Brillnova/BN-USV-V2/docs/usv-v2-field-test.jpg

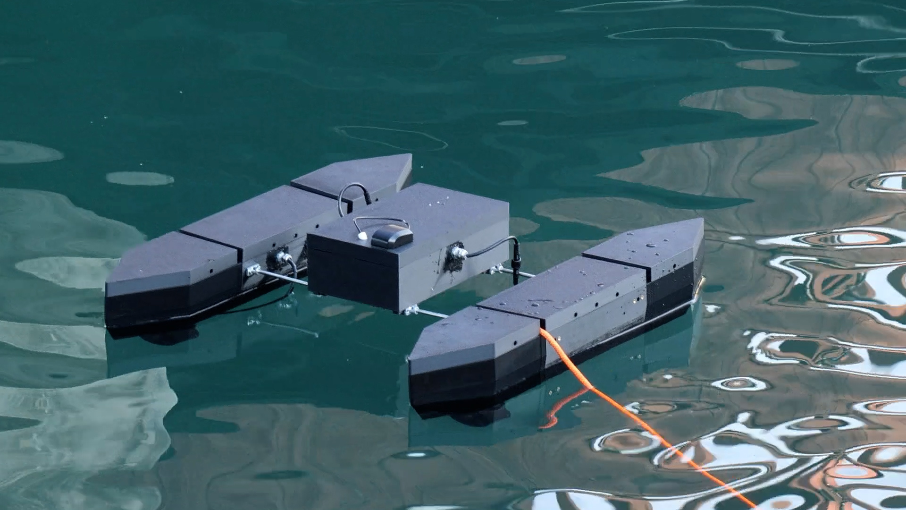
docs/usv-v2-field-test.jpg
