Brillnova/BN-USV-V2/docs/usv-v1.jpg

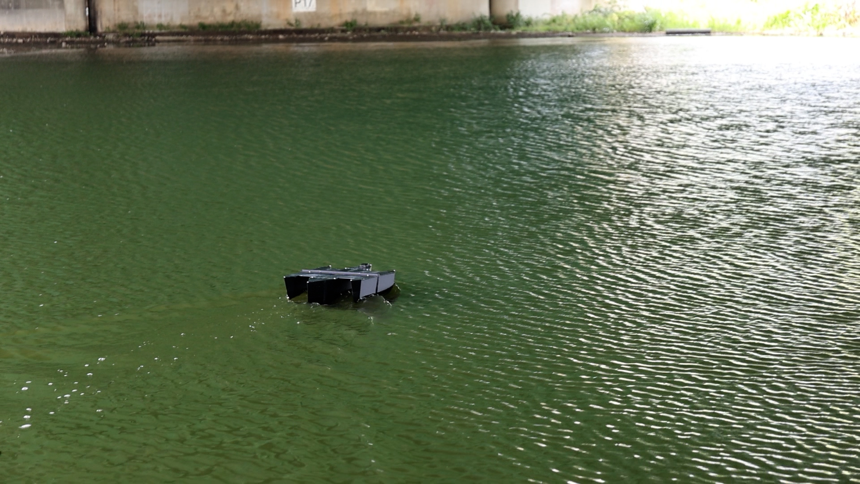
docs/usv-v1.jpg
