Brillnova/BN-USV-V2/hardware/stl/Main Module/Main Module Housing.stl

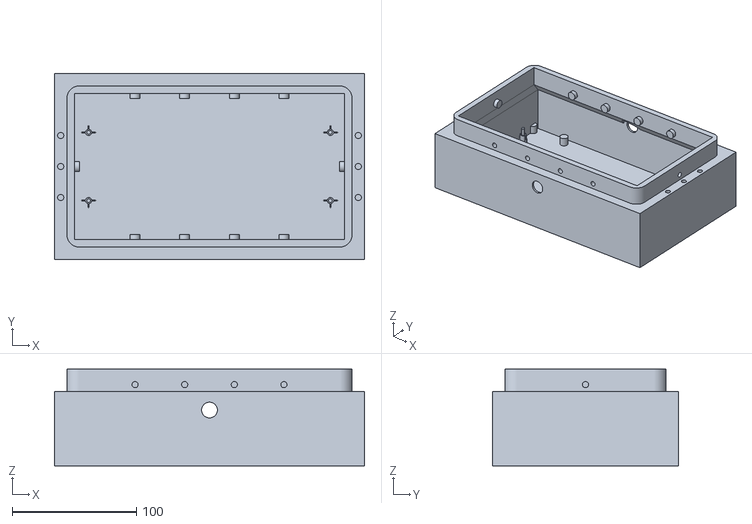
[picture p3: CAD file, 2026-10-26]
hardware/stl/Main Module/Main Module Housing.stl
250.0 x 150.0 x 78.0
