Brillnova/BN-USV-V2/hardware/stl/Weight pallet/Main Module/Weight pallet-Main pcb plate.stl

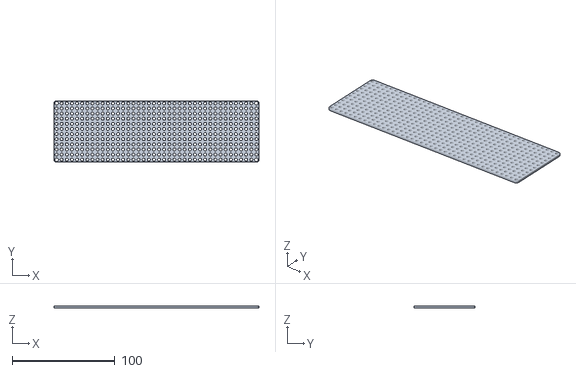
[picture p4: CAD file, 2026-10-26]
hardware/stl/Weight pallet/Main Module/Weight pallet-Main pcb plate.stl
200.0 x 60.0 x 2.00
