Brillnova/BN-USV-V2/hardware/stl/Main Module/Main Module Cover.stl

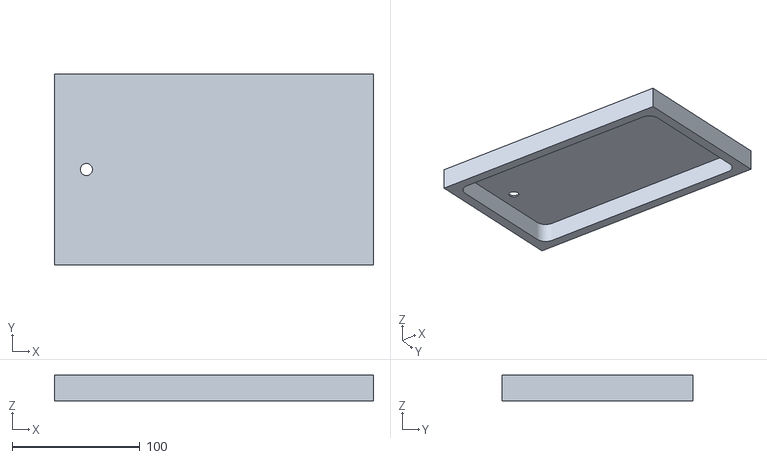
[picture p5: CAD file, 2026-10-26]
hardware/stl/Main Module/Main Module Cover.stl
250.0 x 150.0 x 20.0
