Brillnova/BN-USV-V2/hardware/stl/Main Module/Main Module Axis Support.stl

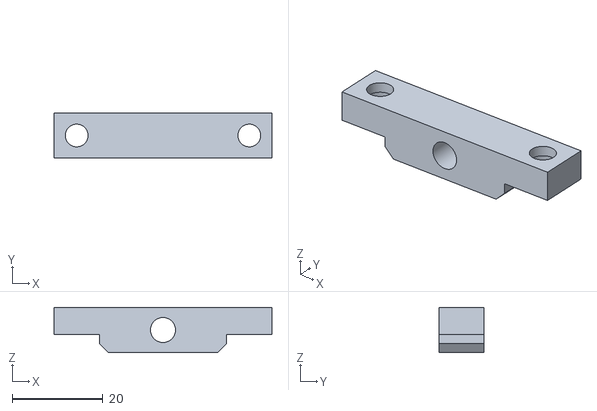
[picture p6: CAD file, 2026-10-26]
hardware/stl/Main Module/Main Module Axis Support.stl
48.0 x 10.0 x 10.0
