Brillnova/BN-USV-V2/hardware/stl/Connection/Module Connection_F.stl

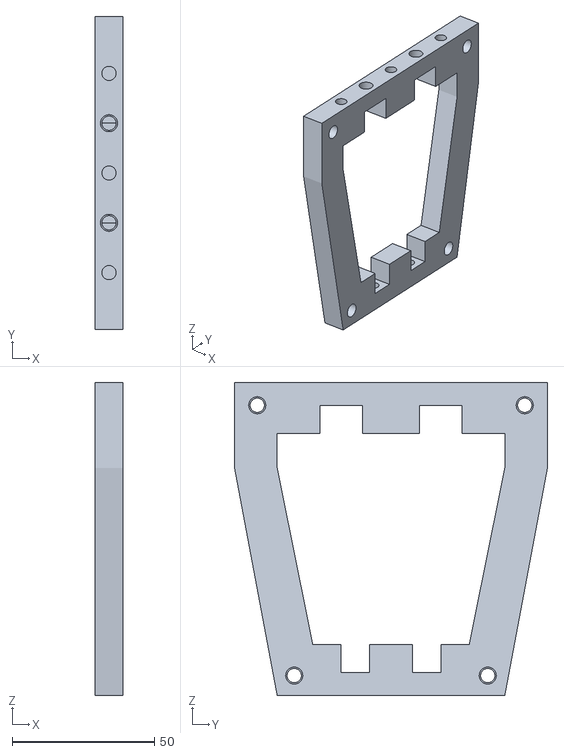
[picture p7: CAD file, 2026-10-26]
hardware/stl/Connection/Module Connection_F.stl
10.0 x 110.0 x 110.0
