Brillnova/BN-USV-V2/hardware/stl/Sub FWD & AFT/Sub FWD Module Housing.stl

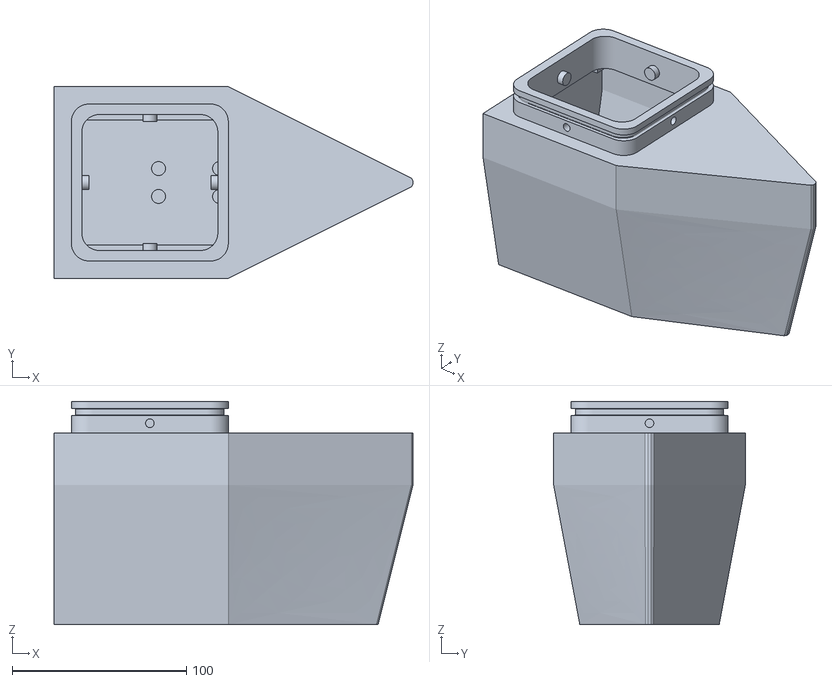
[picture p8: CAD file, 2026-10-26]
hardware/stl/Sub FWD & AFT/Sub FWD Module Housing.stl
206.0 x 110.0 x 128.0
