Brillnova/BN-USV-V2/hardware/stl/Sub Mid/Sub MID Module Housing.stl

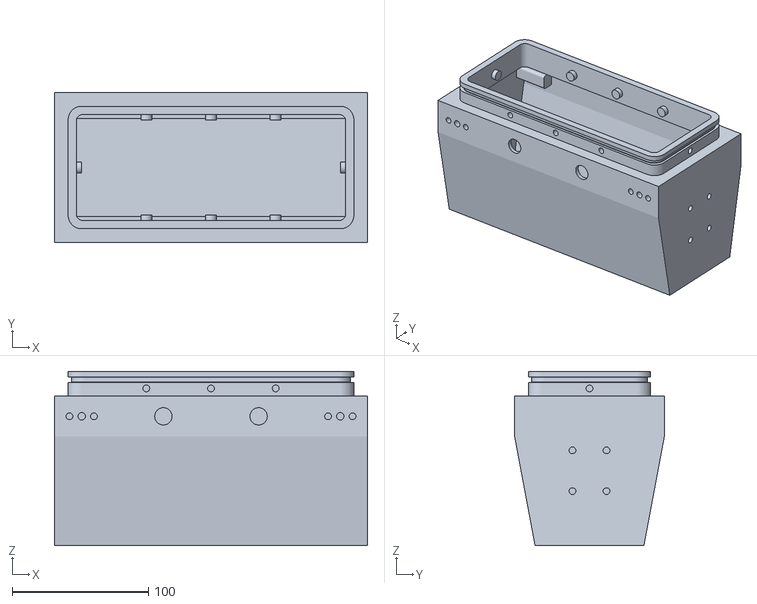
[picture p9: CAD file, 2026-10-26]
hardware/stl/Sub Mid/Sub MID Module Housing.stl
230.0 x 110.0 x 128.0
