Brillnova/BN-USV-V2/hardware/stl/Weight pallet/Tools/Weight pallet-pcb pannel cap.stl

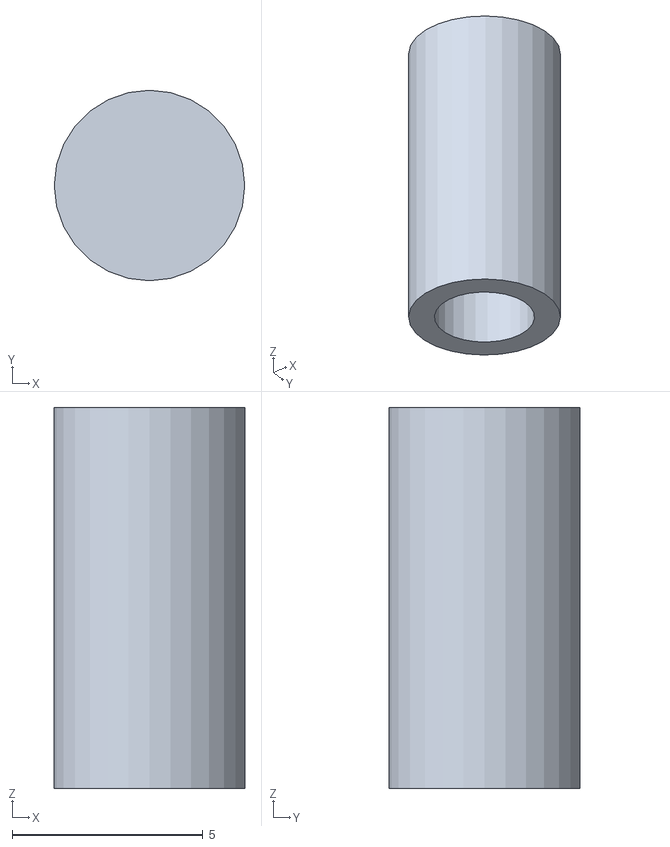
[picture p11: CAD file, 2026-10-26]
hardware/stl/Weight pallet/Tools/Weight pallet-pcb pannel cap.stl
5.00 x 5.00 x 10.0
