Brillnova/BN-USV-V2/hardware/stl/Connection/Module Connection_M.stl

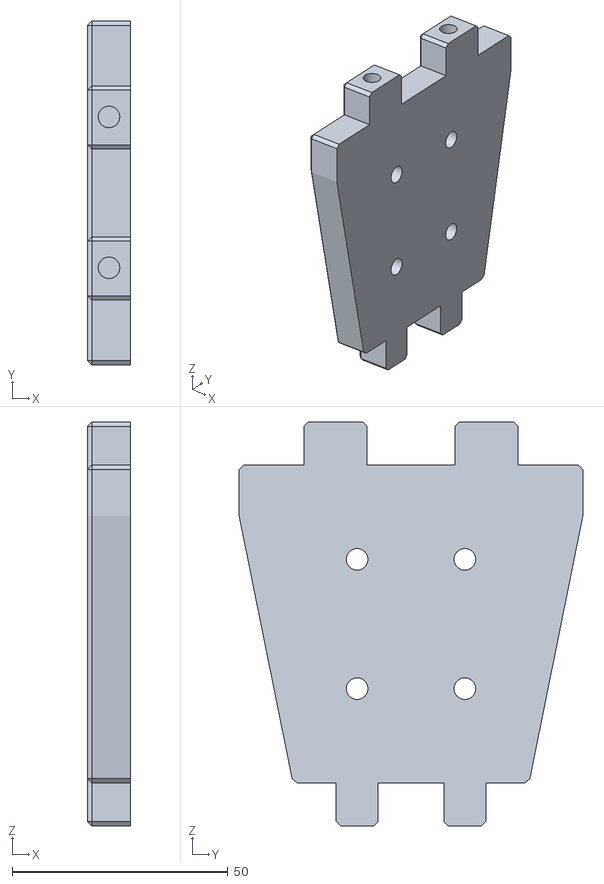
[picture p12: CAD file, 2026-10-26]
hardware/stl/Connection/Module Connection_M.stl
10.0 x 79.7 x 93.7
