Brillnova/BN-USV-V2/hardware/stl/Sub FWD & AFT/Thrust Module_F.stl

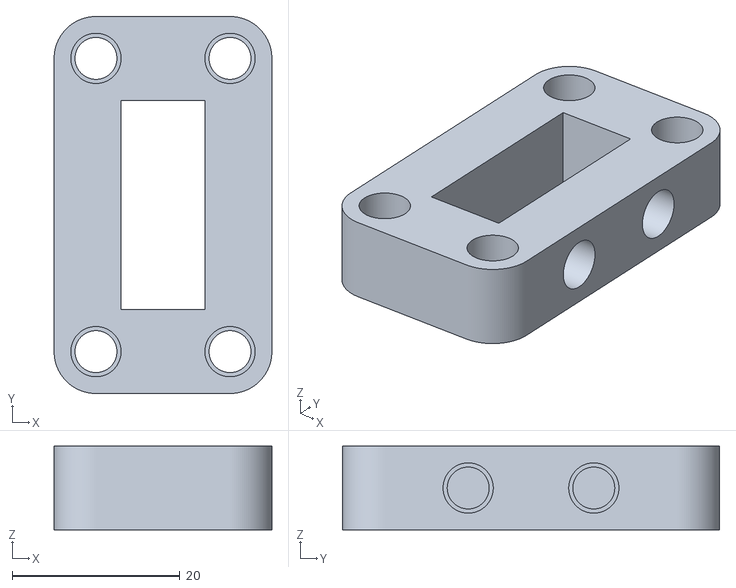
[picture p13: CAD file, 2026-10-26]
hardware/stl/Sub FWD & AFT/Thrust Module_F.stl
26.0 x 45.0 x 10.0
