Brillnova/BN-USV-V2/hardware/stl/Sub Mid/Sub MID Module Housing Cover.stl

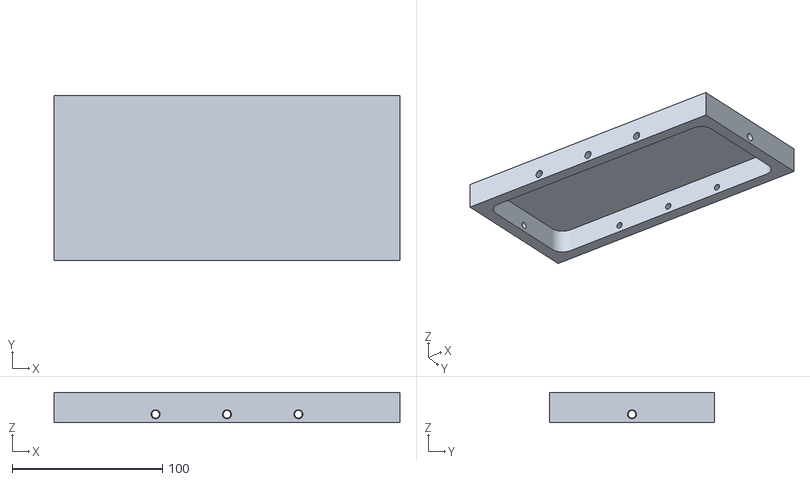
[picture p14: CAD file, 2026-10-26]
hardware/stl/Sub Mid/Sub MID Module Housing Cover.stl
230.0 x 110.0 x 20.0
