Brillnova/BN-USV-V2/hardware/stl/Weight pallet/Sub Module/Weight pallet-AFT_FWD_1st_layer_2.stl

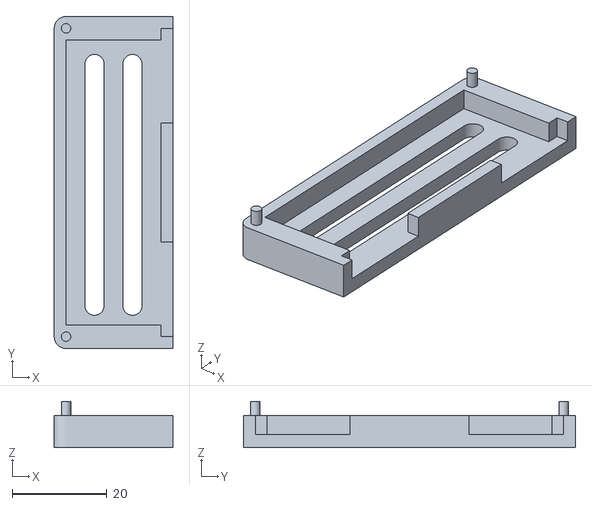
[picture p15: CAD file, 2026-10-26]
hardware/stl/Weight pallet/Sub Module/Weight pallet-AFT_FWD_1st_layer_2.stl
25.0 x 70.0 x 9.80
