Brillnova/BN-USV-V2/hardware/stl/Weight pallet/Tools/Weight pallet-pcb pannel extension.stl

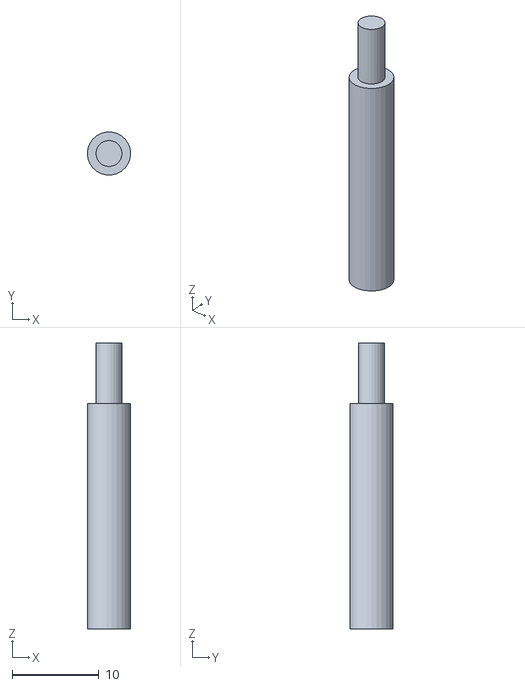
[picture p16: CAD file, 2026-10-26]
hardware/stl/Weight pallet/Tools/Weight pallet-pcb pannel extension.stl
5.00 x 4.96 x 33.0
