Brillnova/BN-USV-V2/hardware/stl/Sub FWD & AFT/Sub FWD Module Cover.stl

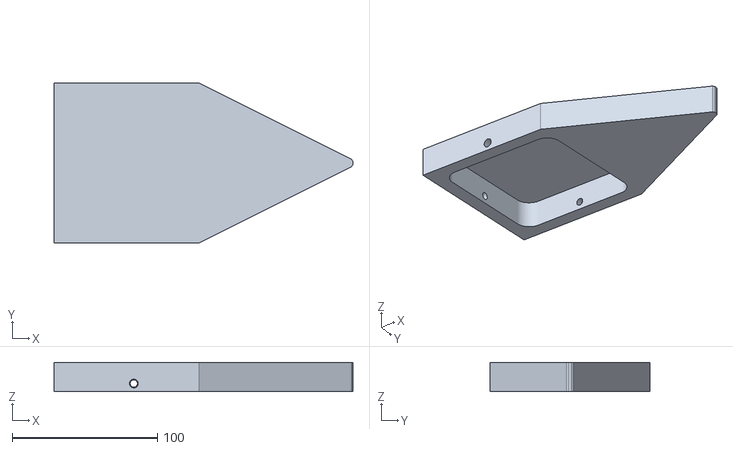
[picture p17: CAD file, 2026-10-26]
hardware/stl/Sub FWD & AFT/Sub FWD Module Cover.stl
206.0 x 110.0 x 20.0
