Brillnova/BN-USV-V2/hardware/stl/Weight pallet/Sub Module/Weight pallet-MID cover plate_1.stl

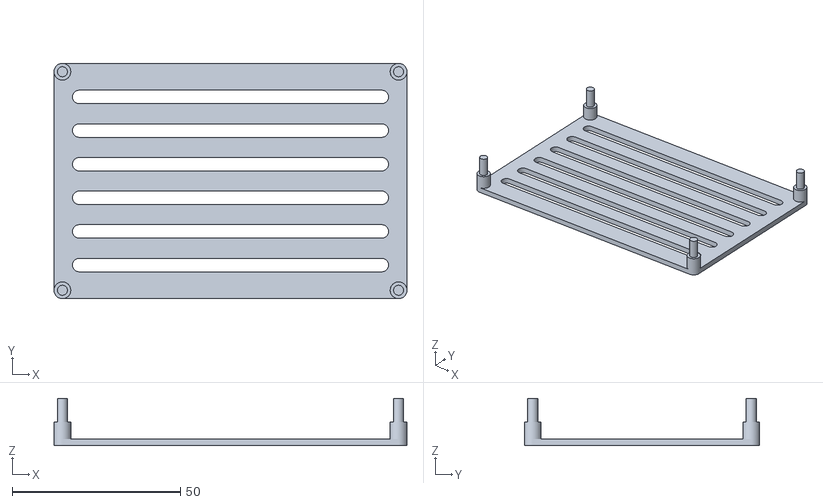
[picture p18: CAD file, 2026-10-26]
hardware/stl/Weight pallet/Sub Module/Weight pallet-MID cover plate_1.stl
105.0 x 70.0 x 14.0
