Brillnova/BN-USV-V2/hardware/stl/Sub FWD & AFT/Thrust Module_M.stl

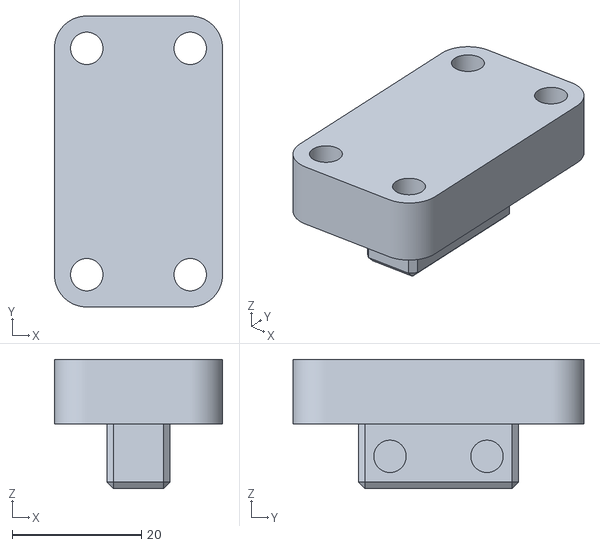
[picture p19: CAD file, 2026-10-26]
hardware/stl/Sub FWD & AFT/Thrust Module_M.stl
26.0 x 45.0 x 20.0
