Brillnova/BN-USV-V2/hardware/stl/Weight pallet/Sub Module/Weight pallet-AFT_FWD_2nd_layer_2.stl

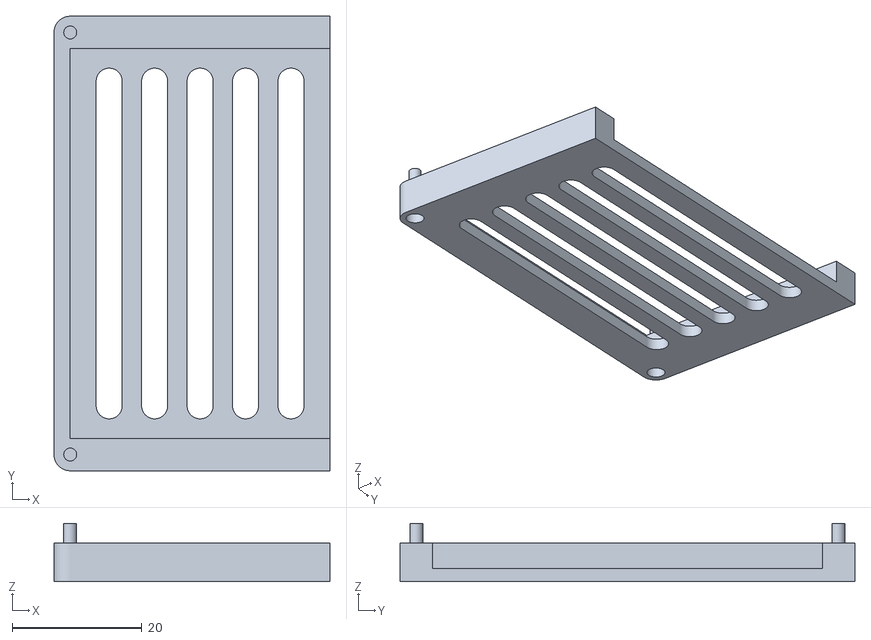
[picture p20: CAD file, 2026-10-26]
hardware/stl/Weight pallet/Sub Module/Weight pallet-AFT_FWD_2nd_layer_2.stl
42.5 x 70.0 x 9.00
