Brillnova/BN-USV-V2/hardware/stl/Weight pallet/Sub Module/Weight pallet-MID pcb plate_2.stl

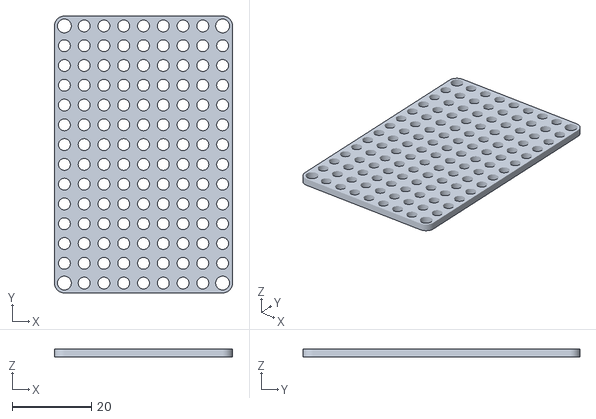
[picture p21: CAD file, 2026-10-26]
hardware/stl/Weight pallet/Sub Module/Weight pallet-MID pcb plate_2.stl
45.0 x 70.0 x 2.00
