Brillnova/BN-USV-V2/hardware/stl/Weight pallet/Sub Module/Weight pallet-MID_1st_layer_1.stl

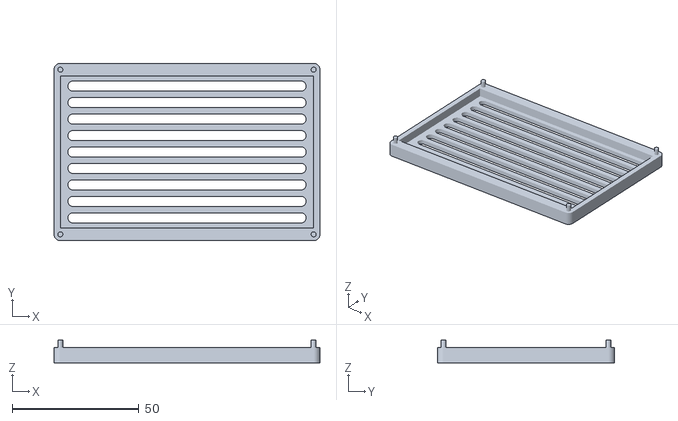
[picture p22: CAD file, 2026-10-26]
hardware/stl/Weight pallet/Sub Module/Weight pallet-MID_1st_layer_1.stl
105.0 x 70.0 x 9.00
