Brillnova/BN-USV-V2/hardware/stl/Weight pallet/Sub Module/Weight pallet-AFT_FWD pcb plate.stl

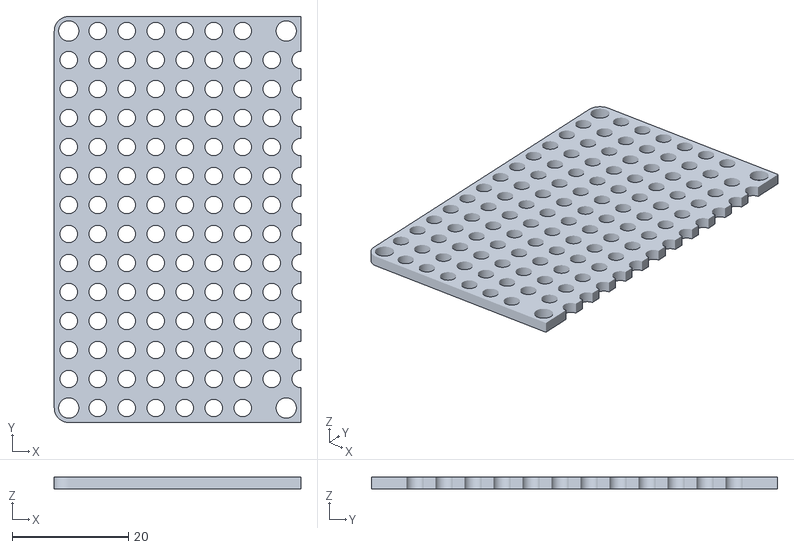
[picture p24: CAD file, 2026-10-26]
hardware/stl/Weight pallet/Sub Module/Weight pallet-AFT_FWD pcb plate.stl
42.5 x 70.0 x 2.00
