Brillnova/BN-USV-V2/hardware/stl/Weight pallet/Sub Module/Weight pallet-AFT_FWD cover plate_1.stl

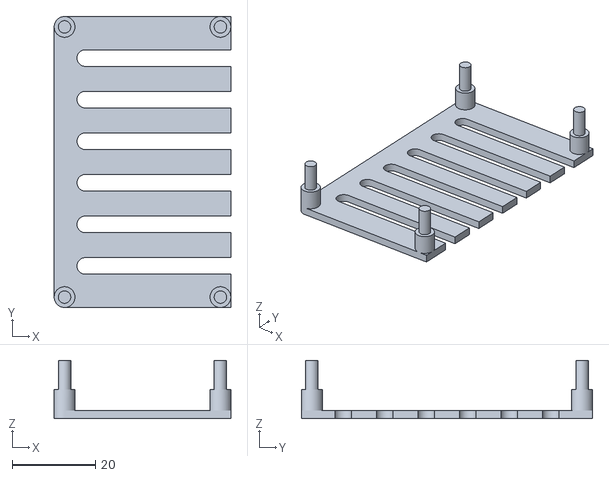
[picture p25: CAD file, 2026-10-26]
hardware/stl/Weight pallet/Sub Module/Weight pallet-AFT_FWD cover plate_1.stl
42.5 x 70.0 x 14.0
