Brillnova/BN-USV-V2/hardware/stl/Weight pallet/Sub Module/Weight pallet-AFT_FWD_tri_1st_layer.stl

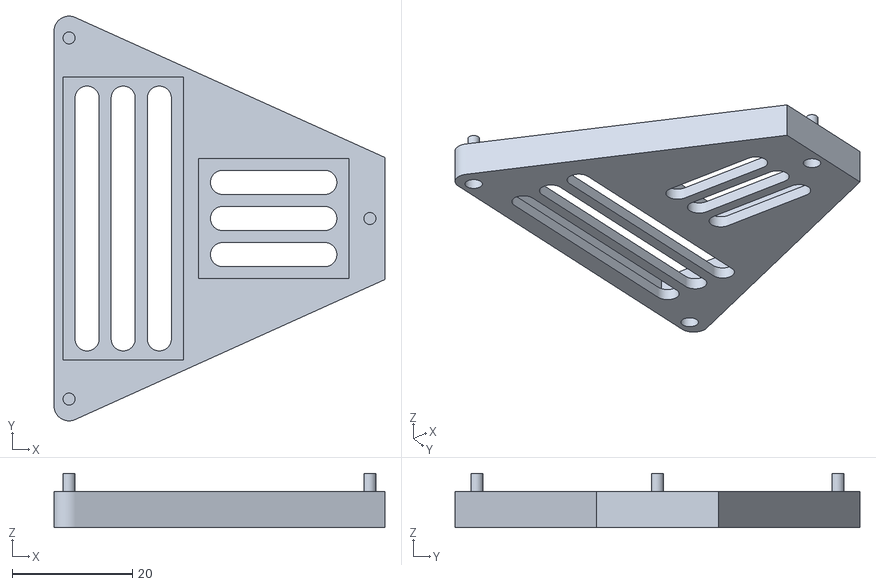
[picture p26: CAD file, 2026-10-26]
hardware/stl/Weight pallet/Sub Module/Weight pallet-AFT_FWD_tri_1st_layer.stl
55.0 x 67.3 x 9.00
