Brillnova/BN-USV-V2/(list of files, cad)

Other CAD files:
hardware/stl/Weight pallet/Sub Module/Weight pallet-MID_1st_layer_2.stl
hardware/stl/Weight pallet/Sub Module/Weight pallet-AFT_FWD_2nd_layer_1.stl
hardware/stl/Weight pallet/Sub Module/Weight pallet-MID cover plate_2.stl
