Brillnova/BN-USV-V2/software/firmware/common/secrets_example.h

#pragma once

// Copy this file to firmware/common/secrets.h for local bench builds.
// Do not commit real Wi-Fi credentials.

#define ENABLE_OTA 1
#define BN_WIFI_SSID "your-wifi-ssid"
#define BN_WIFI_PASSWORD "your-wifi-password"

// Optional. Leave undefined if not needed.
// #define BN_OTA_PASSWORD "your-ota-password"
