Brillnova/BN-USV-V2/(commit log)

2026-10-26 Publish BN-USV V2 prototype sources and STL
2026-10-26 License V2 STL models under CC BY-NC-SA 4.0
